Zitty59/mechanical-manipulator-arm/Screenshots/Claw_assembly.png

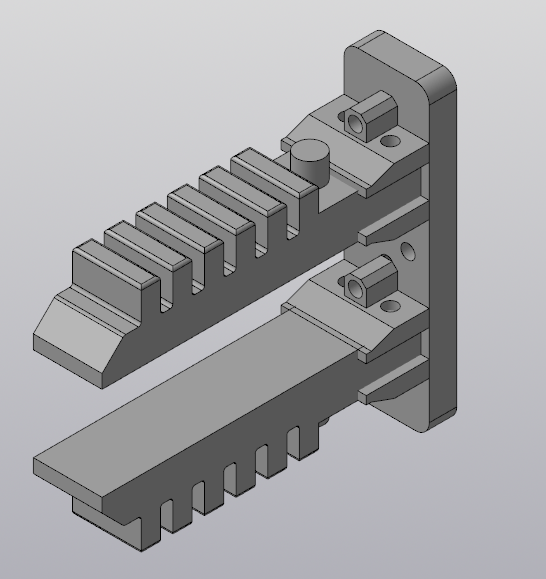
Screenshots/Claw_assembly.png
