Zitty59/mechanical-manipulator-arm/Screenshots/Limb_Holder(screenshot).png

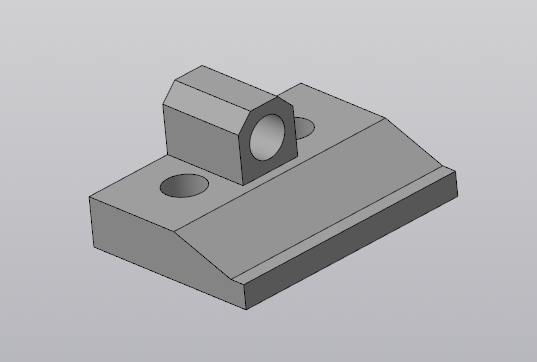
Screenshots/Limb_Holder(screenshot).png
