Zitty59/mechanical-manipulator-arm/Screenshots/Holder_base(screenshot).png

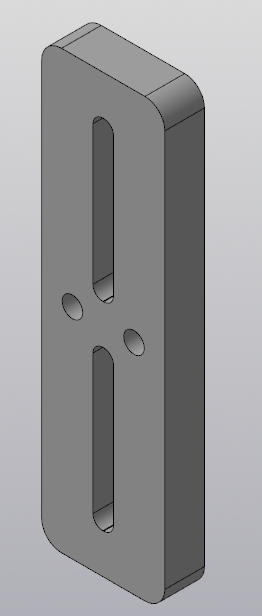
Screenshots/Holder_base(screenshot).png
