Zitty59/mechanical-manipulator-arm/Screenshots/Limb_mold1.png

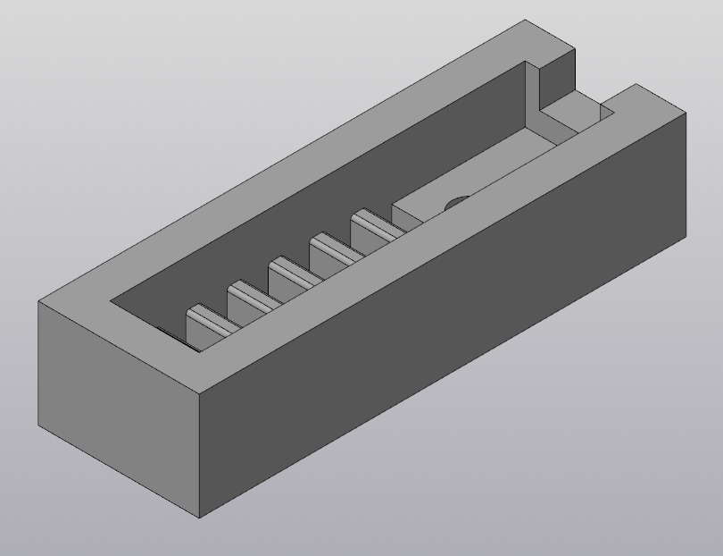
Screenshots/Limb_mold1.png
