Zitty59/mechanical-manipulator-arm/STL/Holder_base_Long.stl

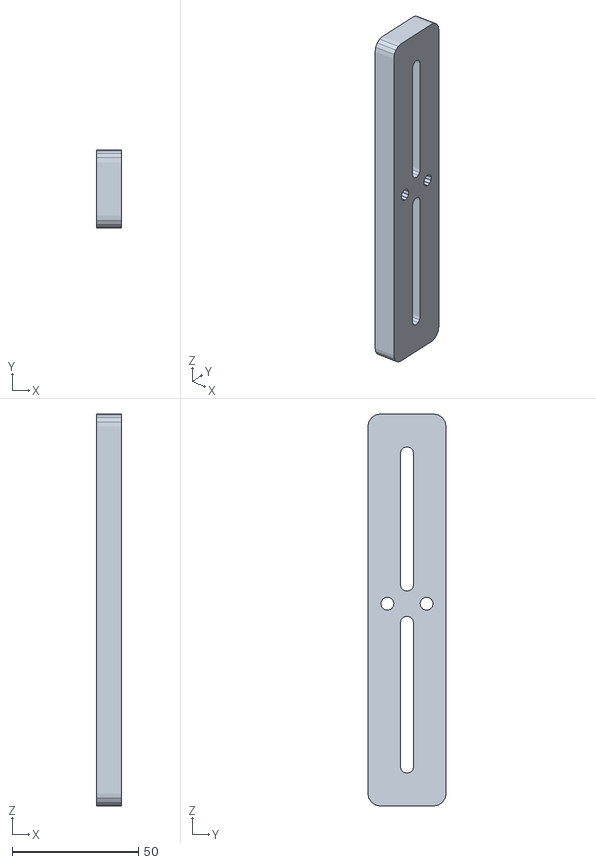
[picture p8: CAD file, 2023-07-02]
STL/Holder_base_Long.stl
10.0 x 31.0 x 155.0
