Zitty59/mechanical-manipulator-arm/STL/Limb_mold_1.stl

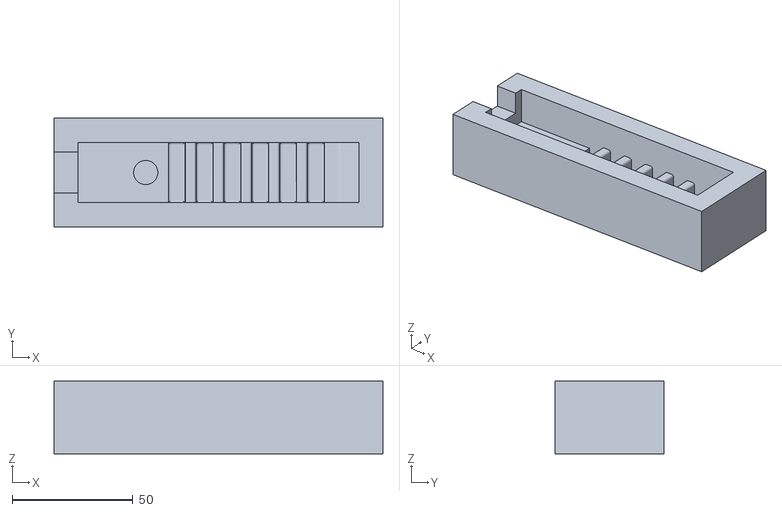
[picture p9: CAD file, 2023-07-02]
STL/Limb_mold_1.stl
136.0 x 45.0 x 30.0
