Zitty59/mechanical-manipulator-arm/STL/Holder_forLimb.stl

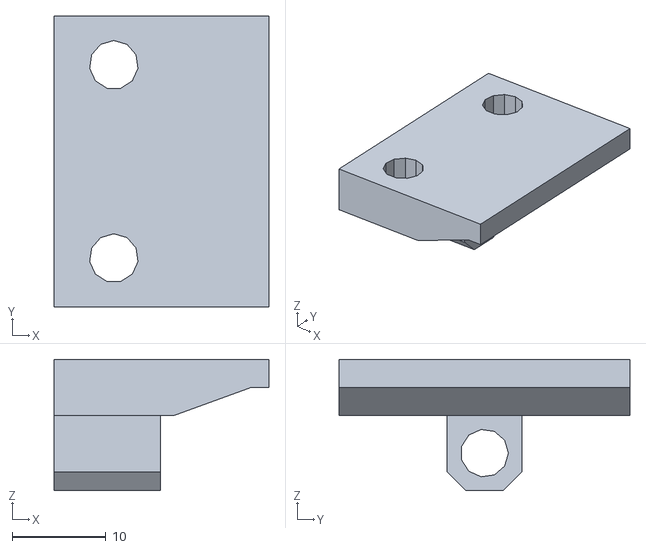
[picture p10: CAD file, 2023-07-02]
STL/Holder_forLimb.stl
22.9 x 31.0 x 14.0
