Zitty59/mechanical-manipulator-arm/STL/Holder_base_short.stl

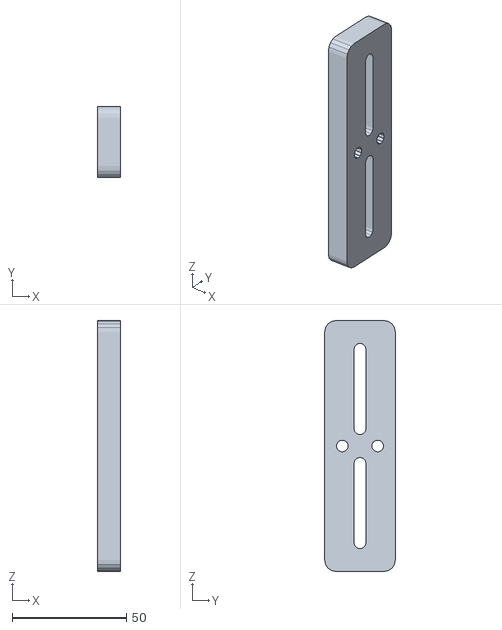
[picture p11: CAD file, 2023-07-02]
STL/Holder_base_short.stl
10.0 x 31.0 x 110.0
